JustTagIt/tesla-driver-2.7/ud27clayout.png

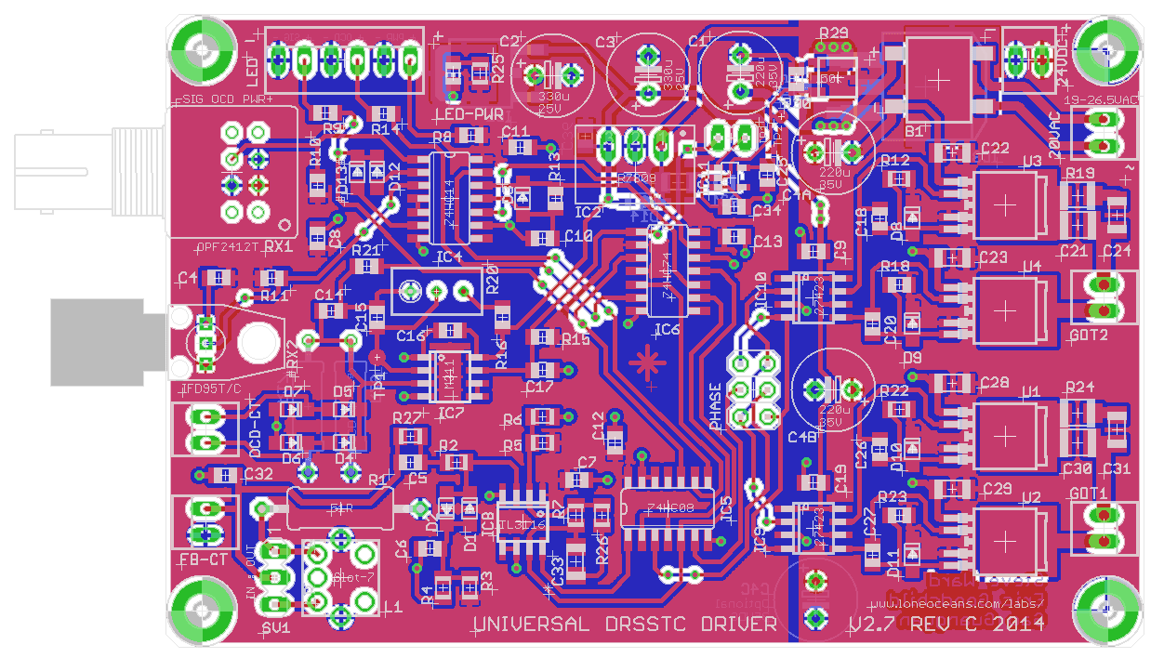
ud27clayout.png
