JustTagIt/tesla-driver-2.7/UD27Cschematic.png

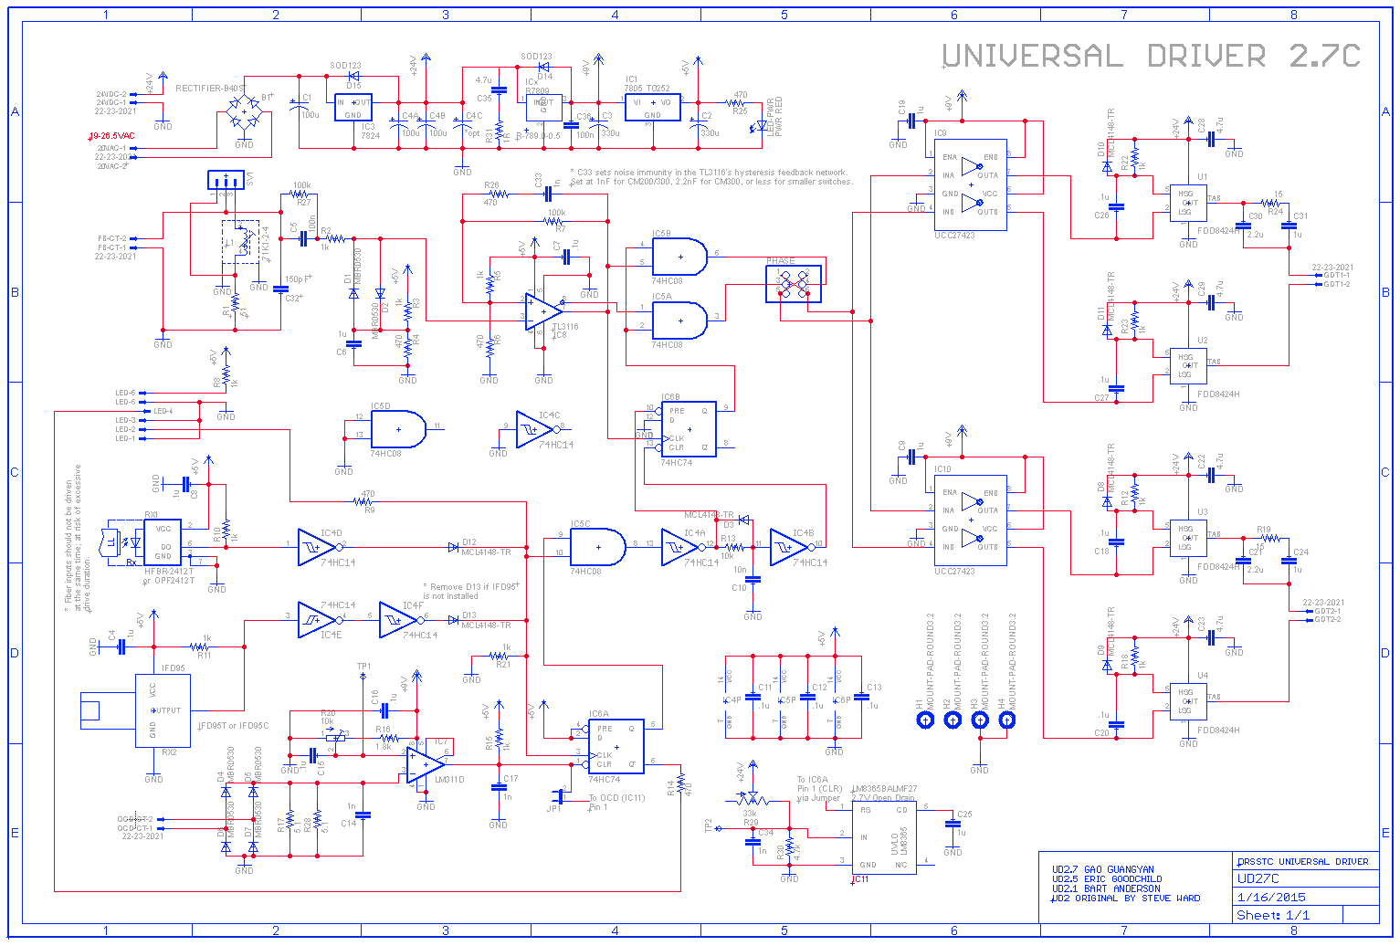
UD27Cschematic.png
