JustTagIt/tesla-driver-2.7/eagle/UD27C.brd

## EAGLE design eagle/UD27C.brd (2015-05-14)

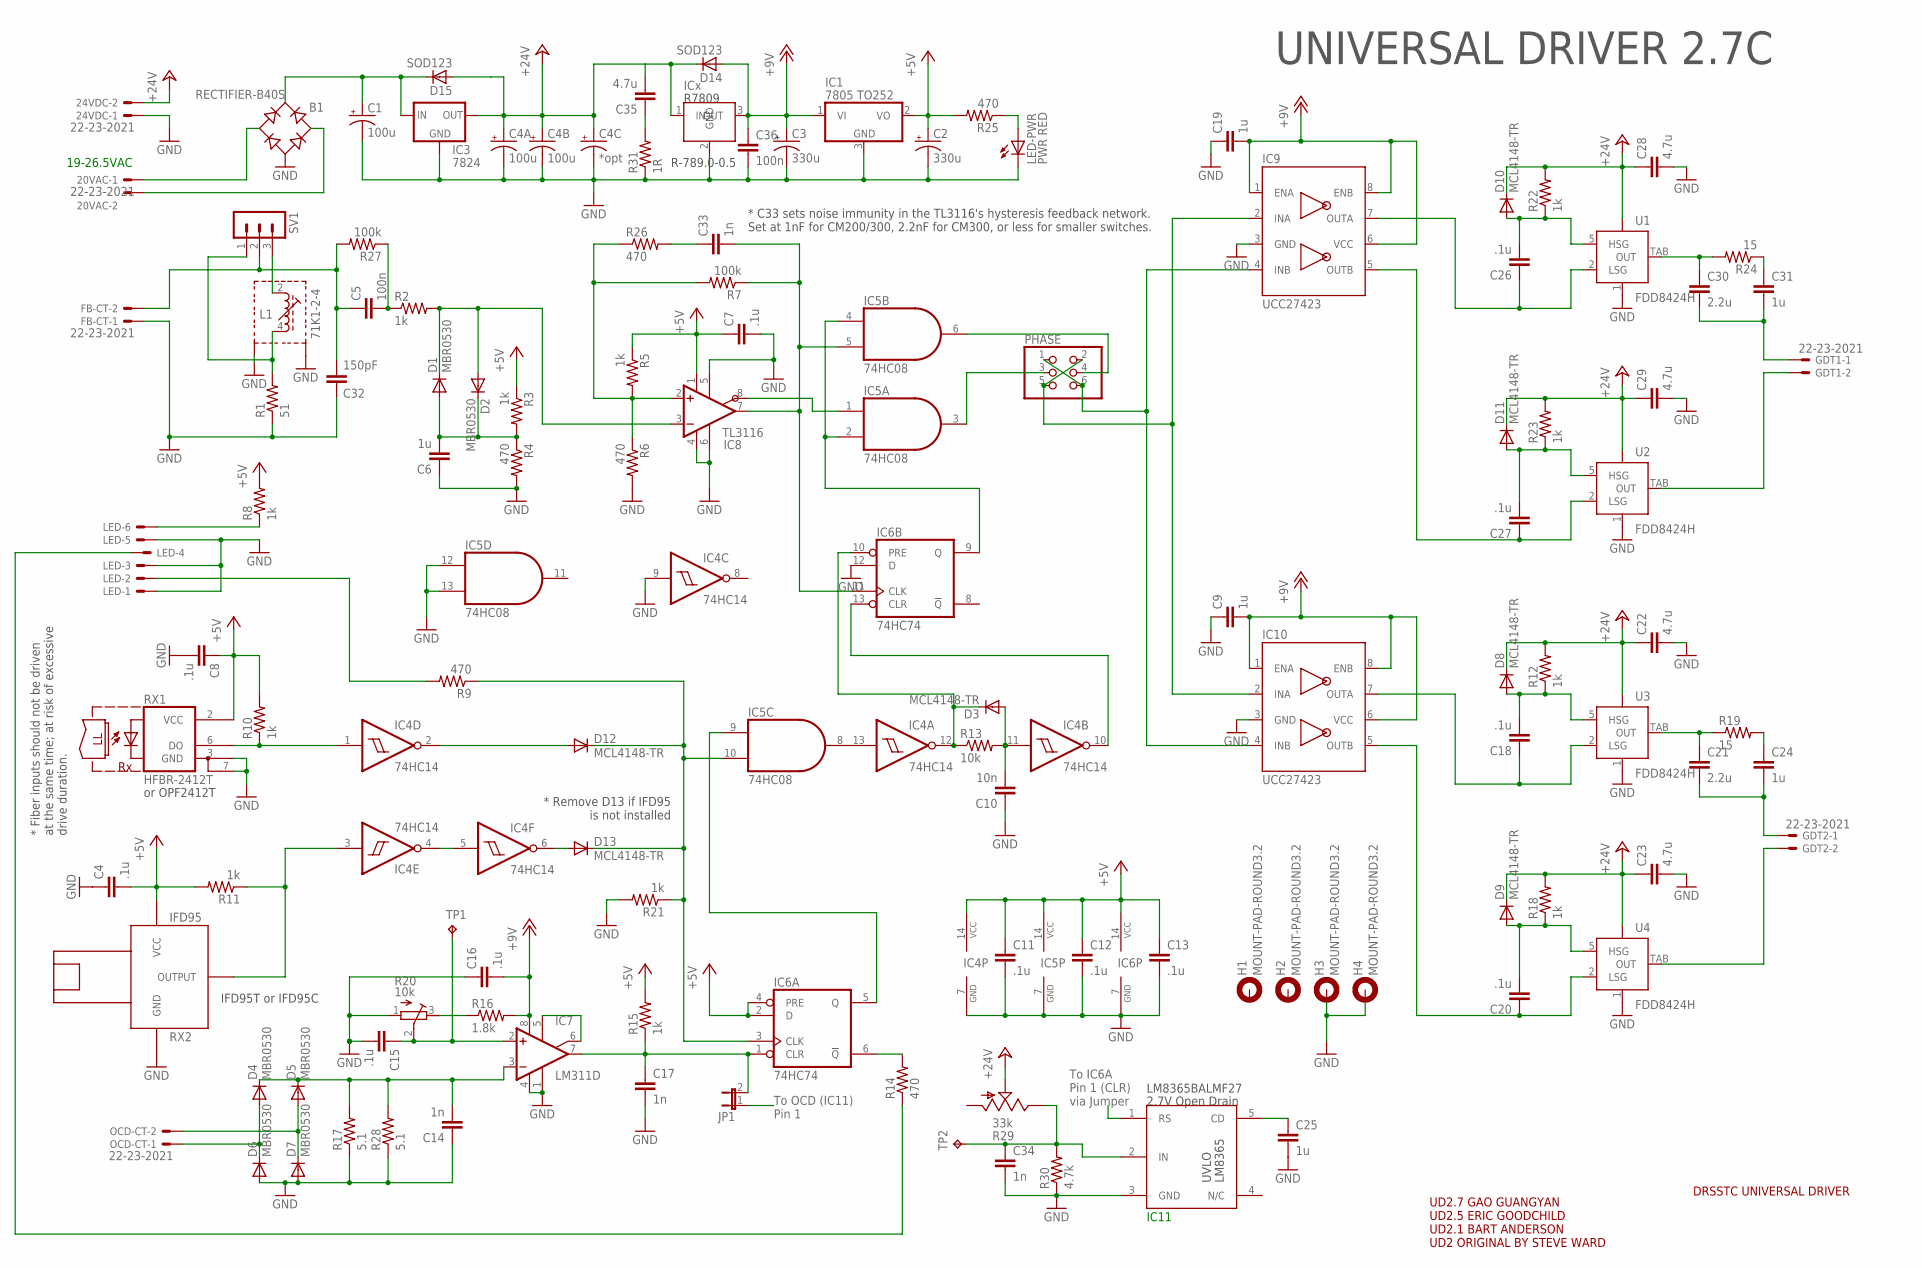
[picture p3: schematic UD27C.sch]

Parts:
20VAC, 24VDC: 22-23-2021
B1: RECTIFIER-B40S; B40S
C1, C4A, C4B: 100u; E3,5-8
C2, C3: 330u; E3,5-8
C4, C7, C8, C11, C12, C13, C15, C16, C18, C20, C26, C27: .1u; C0805
C4C: *opt; E3,5-8
C5, C36: 100n; C0805
C6, C9, C19, C25: 1u; C0805
C10: 10n; C0805
C14, C17, C34: 1n; C0805
C21, C30: 2.2u; C1210
C22, C23, C28, C29: 4.7u; C1206
C24, C31: 1u; C1206
C32: 150pF; C0805
C33: 1n; C1206
C35: 4.7u; C1206K
D1, D2, D4, D5, D6, D7: MBR0530; SOD323-W
D3, D8, D9, D10, D11, D12, D13: MCL4148-TR; SOD323-W
D14, D15: SOD123
FB-CT: 22-23-2021
GDT1, GDT2: 22-23-2021
H1, H2, H3, H4: MOUNT-PAD-ROUND3.2; 3,2-PAD
IC1: 7805 TO252; TO252
IC2: R78XX; TO220S
IC3: 7824; D2PACK
IC4: 74HC14; SO14
IC5: 74HC08; SO14
IC6: 74HC74; SO14
IC7: LM311D; SO08
IC8: TL3116; SO08
IC9, IC10: UCC27423; SO08
IC11: LM8365; SOT25
JP1: JP1E; JP1
L1: 71K1-2-4; 71K
LED: 22-23-2061
LED-PWR: PWR RED; CHIP-LED0805
OCD-CT: 22-23-2021
PHASE: PINHD-2X3; 2X03
R1: 51; 0411/15
R2, R3, R5, R12, R22: 1k; M0805
R4, R6, R25, R26: 470; M0805
R7, R27: 100k; M0805
R8, R10, R11, R15, R18, R21, R23: 1k; R0805
R9, R14: 470; R0805
R13: 10k; R0805
R16: 1.8k; R0805
R17, R28: 5.1; 0309/12
R19, R24: 15; R1210W
R20: 10k; RTRIM3296W
R29: 33k; 3223J
R30: 4.7k; R0805
R31: 1R; M0805
RX1: HFBR-2412T; HFBR-X41XT
RX2: IFD95; OPTO-RECEIVER
SV1: MA03-1
TP1: TPTP16R; TP16R
TP2: TPB1,27; B1,27
U1, U2, U3, U4: FDD8424H; GGY_TO252_5

Connections:
+5V: C2.+, C4.2, C7.1, C8.1, C11.1, C12.1, C13.1, IC1.2 (VO), IC4.14 (VCC), IC5.14 (VCC), IC6.2 (D), IC6.4 (PRE), IC6.14 (VCC), IC8.1 (V+), R3.1, R5.1, R8.2, R10.2, R11.2, R15.2, R25.2, RX1.2 (VCC), RX2.P$3 (VCC)
+12V: C3.+, C9.2, C16.2, C19.2, C36.1, D14.2 (A), IC1.1 (VI), IC2.3 (OUT), IC7.8 (V+), IC9.1 (ENA), IC9.6 (VCC), IC9.8 (ENB), IC10.1 (ENA), IC10.6 (VCC), IC10.8 (ENB), R16.2
+24V: 24VDC.2, C4A.+, C4B.+, C4C.+, C22.1, C23.1, C28.1, C29.1, C35.2, D8.C, D9.C, D10.C, D11.C, D14.1 (C), D15.2 (A), IC2.1 (IN), IC3.3 (OUT), R12.2, R18.2, R22.2, R23.2, R29.2 (S), U1.4 (VBB), U2.4 (VBB), U3.4 (VBB), U4.4 (VBB)
GND: 24VDC.1, B1.-, C1.-, C2.-, C3.-, C4.1, C4A.-, C4B.-, C4C.-, C6.1, C7.2, C8.2, C9.1, C10.1, C11.2, C12.2, C13.2, C14.1, C15.2, C16.1, C17.2, C19.1, C22.2, C23.2, C25.2, C28.2, C29.2, C32.1, C34.2, C36.2, D6.A, D7.A, FB-CT.1, H3.B3,2, H4.B3,2, IC1.3 (GND), IC2.2 (GND), IC3.2 (GND), IC4.7 (GND), IC4.9 (I), IC5.7 (GND), IC5.12 (I0), IC5.13 (I1), IC6.7 (GND), IC6.12 (D), IC7.1 (GND), IC7.4 (V-), IC8.4 (V-), IC8.5 (LATCH), IC8.6 (GND), IC9.3 (GND), IC10.3 (GND), IC11.3 (GND), L1.S1, L1.S2, LED.1, LED.3, LED.5, LED-PWR.C, R1.1, R4.2, R6.2, R17.1, R20.1 (E), R21.2, R28.1, R30.1, R31.1, RX1.3 (GND), RX1.7 (GND1), RX2.P$1 (GND), U1.1 (GND), U2.1 (GND), U3.1 (GND), U4.1 (GND)
unnamed: IC5.6 (O), PHASE.4
unnamed: L1.4 (E), R1.2, SV1.1
unnamed: IC4.1 (I), R10.1, RX1.6 (DO)
unnamed: R16.1, R20.3 (A)
unnamed: B1.+, C1.+, D15.1 (C), IC3.1 (IN)
unnamed: C33.1, R26.2
unnamed: LED-PWR.A, R25.1
unnamed: C5.1, C32.2, FB-CT.2, R27.2, SV1.2
unnamed: L1.2 (A), SV1.3
unnamed: 20VAC.1, B1.AC1
unnamed: D12.A, IC4.2 (O)
unnamed: D12.C, D13.C, IC5.10 (I1), IC6.3 (CLK), R9.1, R21.1
unnamed: D13.A, IC4.6 (O)
unnamed: IC4.4 (O), IC4.5 (I)
unnamed: C18.1, IC10.7 (OUTA), U3.2 (LSG)
unnamed: IC5.3 (O), PHASE.3
unnamed: IC4.3 (I), R11.1, RX2.P$2 (OUTPUT)
unnamed: C18.2, D8.A, R12.1, U3.5 (HSG)
unnamed: C21.1, R19.1, U3.TAB (OUT)
unnamed: C20.1, IC10.5 (OUTB), U4.2 (LSG)
unnamed: C20.2, D9.A, R18.1, U4.5 (HSG)
unnamed: GDT2.2, U4.TAB (OUT)
unnamed: IC9.4 (INB), IC10.4 (INB), PHASE.1, PHASE.6
unnamed: C24.1, R19.2
unnamed: IC9.2 (INA), IC10.2 (INA), PHASE.2, PHASE.5
unnamed: C31.1, R24.1
unnamed: C30.2, C31.2, GDT1.1
unnamed: C21.2, C24.2, GDT2.1
unnamed: C25.1, IC11.5 (CD)
unnamed: IC11.1 (RS), JP1.1
unnamed: C34.1, IC11.2 (IN), R29.3 (E), R30.2, TP2.TP
unnamed: C35.1, R31.2
unnamed: IC5.2 (I1), IC5.4 (I0), IC6.9 (Q)
unnamed: C17.1, IC6.1 (CLR), IC7.7 (OUT), JP1.2, R15.1
unnamed: D3.C, IC4.12 (O), IC6.10 (PRE), R13.1
unnamed: C10.2, D3.A, IC4.11 (I), R13.2
unnamed: IC4.10 (O), IC6.13 (CLR)
unnamed: IC7.5 (ON), IC7.6 (ON/STR)
unnamed: C15.1, IC7.2 (+IN), R20.2 (S), TP1.TP
unnamed: C14.2, D4.C, D5.C, IC7.3 (-IN), R17.2, R28.2
unnamed: 20VAC.2, B1.AC2
unnamed: D5.A, D7.C, OCD-CT.2
unnamed: D4.A, D6.C, OCD-CT.1
unnamed: IC4.13 (I), IC5.8 (O)
unnamed: IC6.6 (!Q), R14.2
unnamed: C33.2, IC5.5 (I1), IC6.11 (CLK), IC8.7 (Q), R7.1
unnamed: IC8.2 (+IN), R5.2, R6.1, R7.2, R26.1
unnamed: C5.2, R2.1, R27.1
unnamed: D1.C, D2.A, IC8.3 (-IN), R2.2
unnamed: C6.2, D1.A, D2.C, R3.2, R4.1
unnamed: IC5.1 (I0), IC8.8 (QNOT)
unnamed: IC5.9 (I0), IC6.5 (Q)
unnamed: C26.1, IC9.7 (OUTA), U1.2 (LSG)
unnamed: C26.2, D10.A, R22.1, U1.5 (HSG)
unnamed: C30.1, R24.2, U1.TAB (OUT)
unnamed: C27.1, IC9.5 (OUTB), U2.2 (LSG)
unnamed: C27.2, D11.A, R23.1, U2.5 (HSG)
unnamed: GDT1.2, U2.TAB (OUT)
unnamed: LED.6, R8.1
unnamed: LED.4, R14.1
unnamed: LED.2, R9.2

Notes on the sheet:
or OPF2412T
IFD95T or IFD95C
IC11
DRSSTC UNIVERSAL DRIVER
UD2.7 GAO GUANGYAN UD2.5 ERIC GOODCHILD UD2.1 BART ANDERSON UD2 ORIGINAL BY STEVE WARD
2.7V Open Drain
LM8365BALMF27
* Fiber inputs should not be driven at the same time; at risk of excessive drive duration.
* Remove D13 if IFD95 is not installed
* C33 sets noise immunity in the TL3116's hysteresis feedback network. Set at 1nF for CM200/300, 2.2nF for CM300, or less for smaller switches.
UNIVERSAL DRIVER 2.7C
To IC6A Pin 1 (CLR) via Jumper
To OCD (IC11) Pin 1
R-789.0-0.5
19-26.5VAC

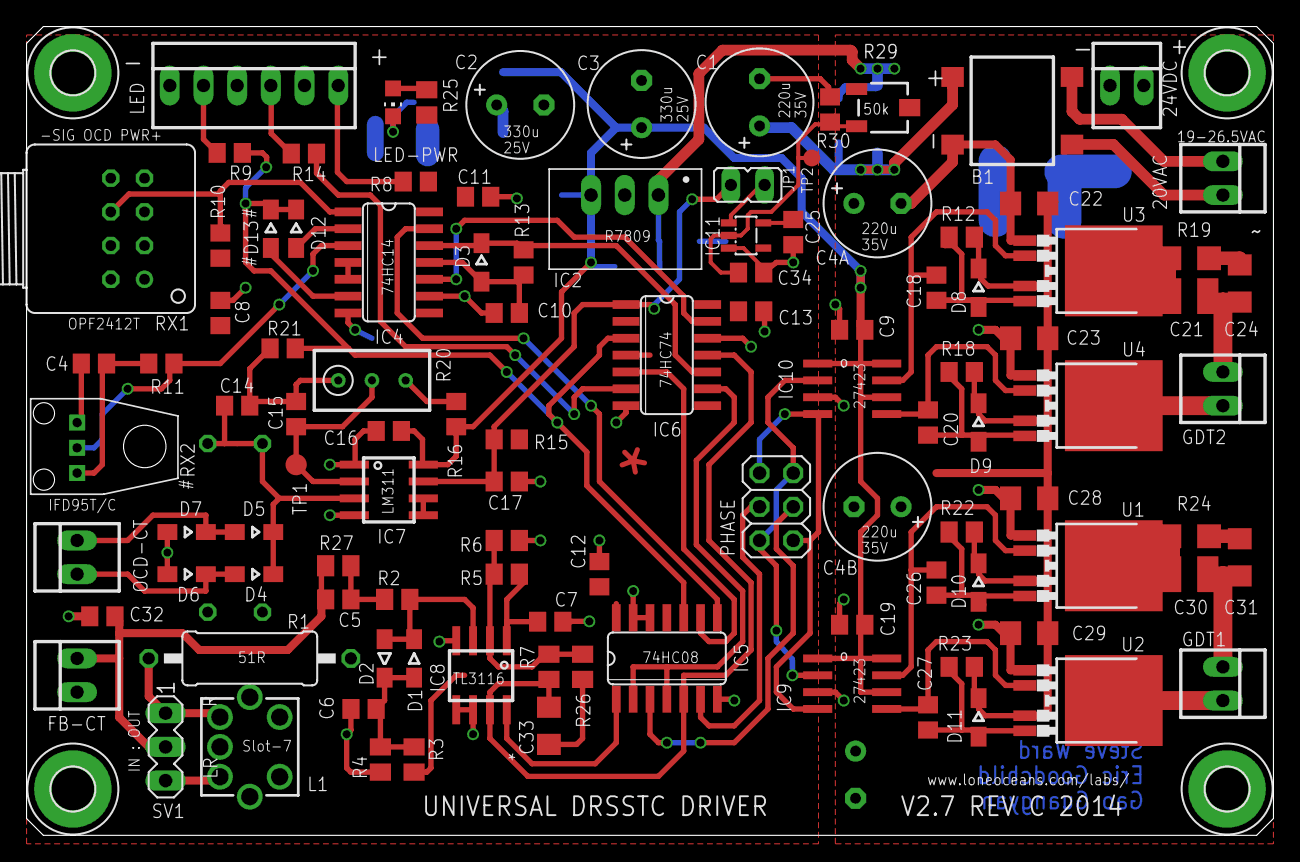
[picture p4: board UD27C.brd from above]

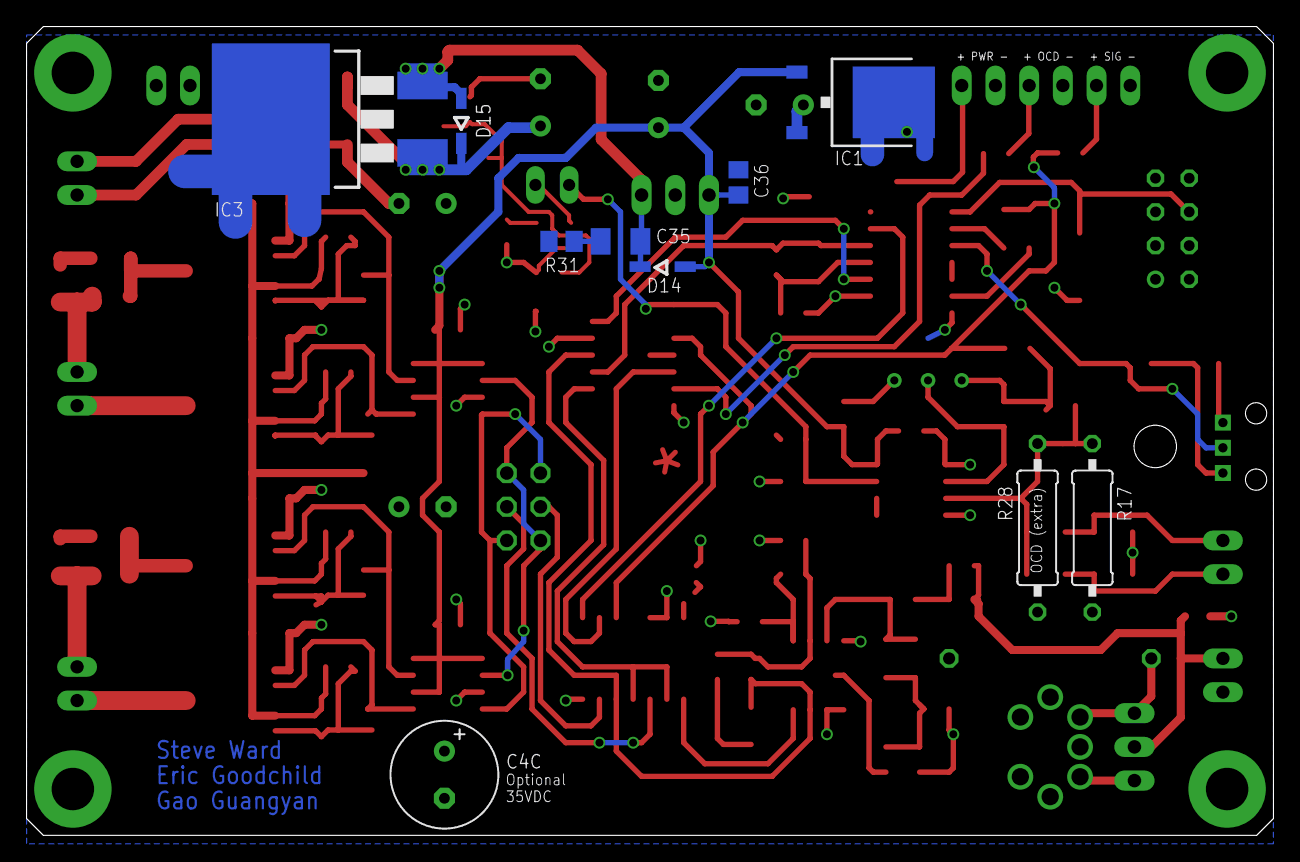
[picture p5: board UD27C.brd from below]

Board: 2 copper layers, 94.0 x 61.0 mm, 121 parts (10 on the bottom side), 65 nets.
